erwinkooiman/SquareWaveVoltammetry/README.md

# SquareWaveVoltammetry
miniaturized potentiostat with web interface 
