erwinkooiman/SquareWaveVoltammetry/kiCad/PEE50_voltametrie.step

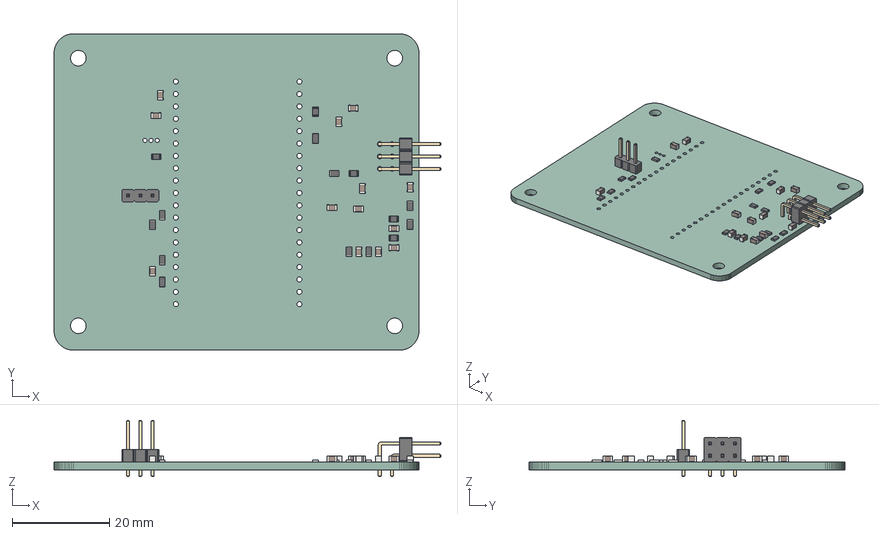
[picture p1: CAD file, 2023-06-14]
kiCad/PEE50_voltametrie.step
79.5 x 65.0 x 11.5 mm
PCB
