erwinkooiman/SquareWaveVoltammetry/kiCad/PEE50_voltametrie.kicad_pcb

## KiCad design kiCad/PEE50_voltametrie.kicad_pcb (2023-06-14)

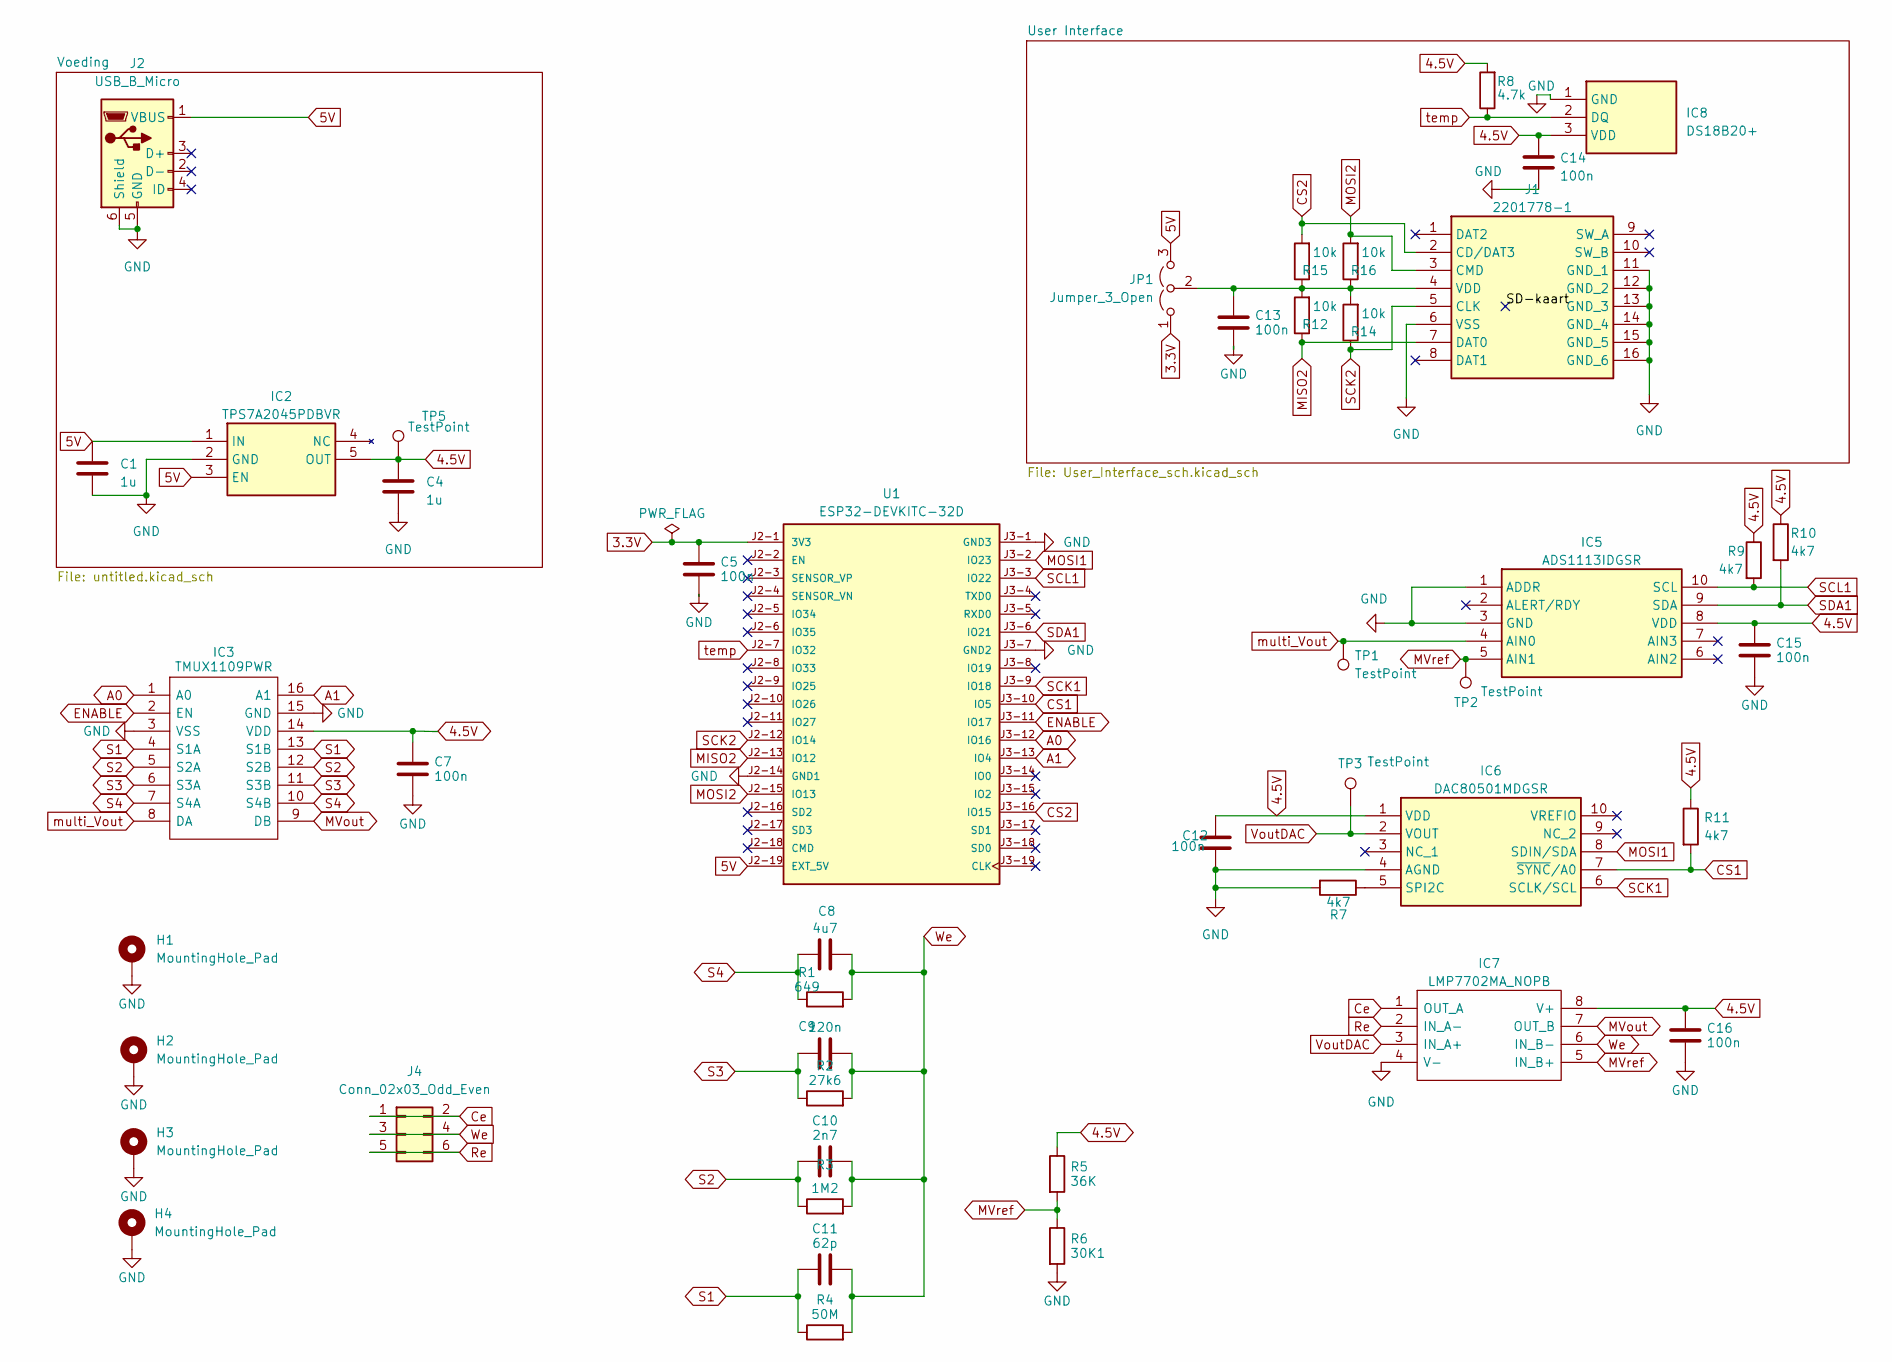
[picture p2: schematic PEE50_voltametrie.kicad_sch]

Parts:
C1, C4: 1u; C_0805_2012Metric_Pad1.18x1.45mm_HandSolder
C5, C7, C12, C13, C14, C15, C16: 100n; C_0805_2012Metric_Pad1.18x1.45mm_HandSolder
C8: 4u7; C_0805_2012Metric_Pad1.18x1.45mm_HandSolder
C9: 120n; C_0805_2012Metric_Pad1.18x1.45mm_HandSolder
C10: 2n7; C_0805_2012Metric_Pad1.18x1.45mm_HandSolder
C11: 62p; C_0805_2012Metric_Pad1.18x1.45mm_HandSolder
H1, H2, H3, H4: MountingHole_Pad; MountingHole_3.2mm_M3_DIN965_Pad
IC2: TPS7A2045PDBVR; SOT95P280X145-5N; Manufacturer_Part_Number TPS7A2045PDBVR; Mouser Part Number 595-TPS7A2045PDBVR
IC3: TMUX1109PWR; SOP65P640X120-16N; Manufacturer_Part_Number TMUX1109PWR; Mouser Part Number 595-TMUX1109PWR
IC5: ADS1113IDGSR; SOP50P490X110-10N; Manufacturer_Part_Number ADS1113IDGSR; Mouser Part Number 595-ADS1113IDGSR
IC6: DAC80501MDGSR; SOP50P490X110-10N; Manufacturer_Part_Number DAC80501MDGSR; Mouser Part Number 595-DAC80501MDGSR
IC7: LMP7702MA_NOPB; SOIC127P600X175-8N; Manufacturer_Part_Number LMP7702MA/NOPB; Mouser Part Number 926-LMP7702MA/NOPB
IC8: DS18B20+; DS18B20; Manufacturer_Part_Number DS18B20+; Mouser Part Number 700-DS18B20+
J1: 2201778-1; 22017781; Manufacturer_Part_Number 2201778-1; Mouser Part Number 571-2201778-1
J2: USB_B_Micro; USB_Micro-B_Amphenol_10104110_Horizontal
J4: Conn_02x03_Odd_Even; PinHeader_2x03_P2.54mm_Horizontal
JP1: Jumper_3_Open; PinHeader_1x03_P2.54mm_Vertical
R1: 649; R_0805_2012Metric_Pad1.20x1.40mm_HandSolder
R2: 27k6; R_0805_2012Metric_Pad1.20x1.40mm_HandSolder
R3: 1M2; R_0805_2012Metric_Pad1.20x1.40mm_HandSolder
R4: 50M; R_0805_2012Metric_Pad1.20x1.40mm_HandSolder
R5: 36K; R_0805_2012Metric_Pad1.20x1.40mm_HandSolder
R6: 30K1; R_0805_2012Metric_Pad1.20x1.40mm_HandSolder
R7, R9, R10, R11: 4k7; R_0805_2012Metric_Pad1.20x1.40mm_HandSolder
R8: 4.7k; R_0805_2012Metric_Pad1.20x1.40mm_HandSolder
R12, R14, R15, R16: 10k; R_0805_2012Metric_Pad1.20x1.40mm_HandSolder
TP1, TP2, TP3, TP5: TestPoint; TestPoint_Pad_D1.0mm
U1: ESP32-DEVKITC-32D; MODULE_ESP32-DEVKITC-32D; PARTREV V4

Connections:
3.3V: C5.1, JP1.1 (A), U1.J2-1 (3V3)
4.5V: C4.1, C7.1, C12.1, C14.1, C15.1, C16.1, IC2.5 (OUT), IC3.14 (VDD), IC5.8 (VDD), IC6.1 (VDD), IC7.8 (V+), IC8.3 (VDD), R5.1, R8.2, R9.1, R10.1, R11.1, TP5.1
5V: C1.1, IC2.1 (IN), IC2.3 (EN), J2.1 (VBUS), JP1.3 (B), U1.J2-19 (EXT_5V)
A0: IC3.1 (A0), U1.J3-12 (IO16)
A1: IC3.16 (A1), U1.J3-13 (IO4)
CS1: IC6.7 (~SYNC/A0), R11.2, U1.J3-10 (IO5)
CS2: J1.2 (CD/DAT3), R15.2, U1.J3-16 (IO15)
Ce: IC7.1 (OUT_A), J4.1, J4.2
ENABLE: IC3.2 (EN), U1.J3-11 (IO17)
GND: C1.2, C4.2, C5.2, C7.2, C12.2, C13.2, C14.2, C15.2, C16.2, H1.1, H2.1, H3.1, H4.1, IC2.2 (GND), IC3.3 (VSS), IC3.15 (GND), IC5.1 (ADDR), IC5.3 (GND), IC6.4 (AGND), IC7.4 (V-), IC8.1 (GND), J1.6 (VSS), J1.11 (GND_1), J1.12 (GND_2), J1.13 (GND_3), J1.14 (GND_4), J1.15 (GND_5), J1.16 (GND_6), J2.5 (GND), J2.6 (Shield), R6.2, R7.2, U1.J2-14 (GND1), U1.J3-1 (GND3), U1.J3-7 (GND2)
MISO2: J1.7 (DAT0), R12.1, U1.J2-13 (IO12)
MOSI1: IC6.8 (SDIN/SDA), U1.J3-2 (IO23)
MOSI2: J1.3 (CMD), R16.2, U1.J2-15 (IO13)
MVout: IC3.9 (DB), IC7.7 (OUT_B)
MVref: IC5.5 (AIN1), IC7.5 (IN_B+), R5.2, R6.1, TP2.1
unnamed: IC6.5 (SPI2C), R7.1
unnamed: C13.1, J1.4 (VDD), JP1.2 (C), R12.2, R14.2, R15.1, R16.1
Re: IC7.2 (IN_A-), J4.5, J4.6
S1: C11.1, IC3.4 (S1A), IC3.13 (S1B), R4.1
S2: C10.1, IC3.5 (S2A), IC3.12 (S2B), R3.1
S3: C9.1, IC3.6 (S3A), IC3.11 (S3B), R2.1
S4: C8.1, IC3.7 (S4A), IC3.10 (S4B), R1.1
SCK1: IC6.6 (SCLK/SCL), U1.J3-9 (IO18)
SCK2: J1.5 (CLK), R14.1, U1.J2-12 (IO14)
SCL1: IC5.10 (SCL), R9.2, U1.J3-3 (IO22)
SDA1: IC5.9 (SDA), R10.2, U1.J3-6 (IO21)
VoutDAC: IC6.2 (VOUT), IC7.3 (IN_A+), TP3.1
We: C8.2, C9.2, C10.2, C11.2, IC7.6 (IN_B-), J4.3, J4.4, R1.2, R2.2, R3.2, R4.2
multi_Vout: IC3.8 (DA), IC5.4 (AIN0), TP1.1
temp: IC8.2 (DQ), R8.1, U1.J2-7 (IO32)

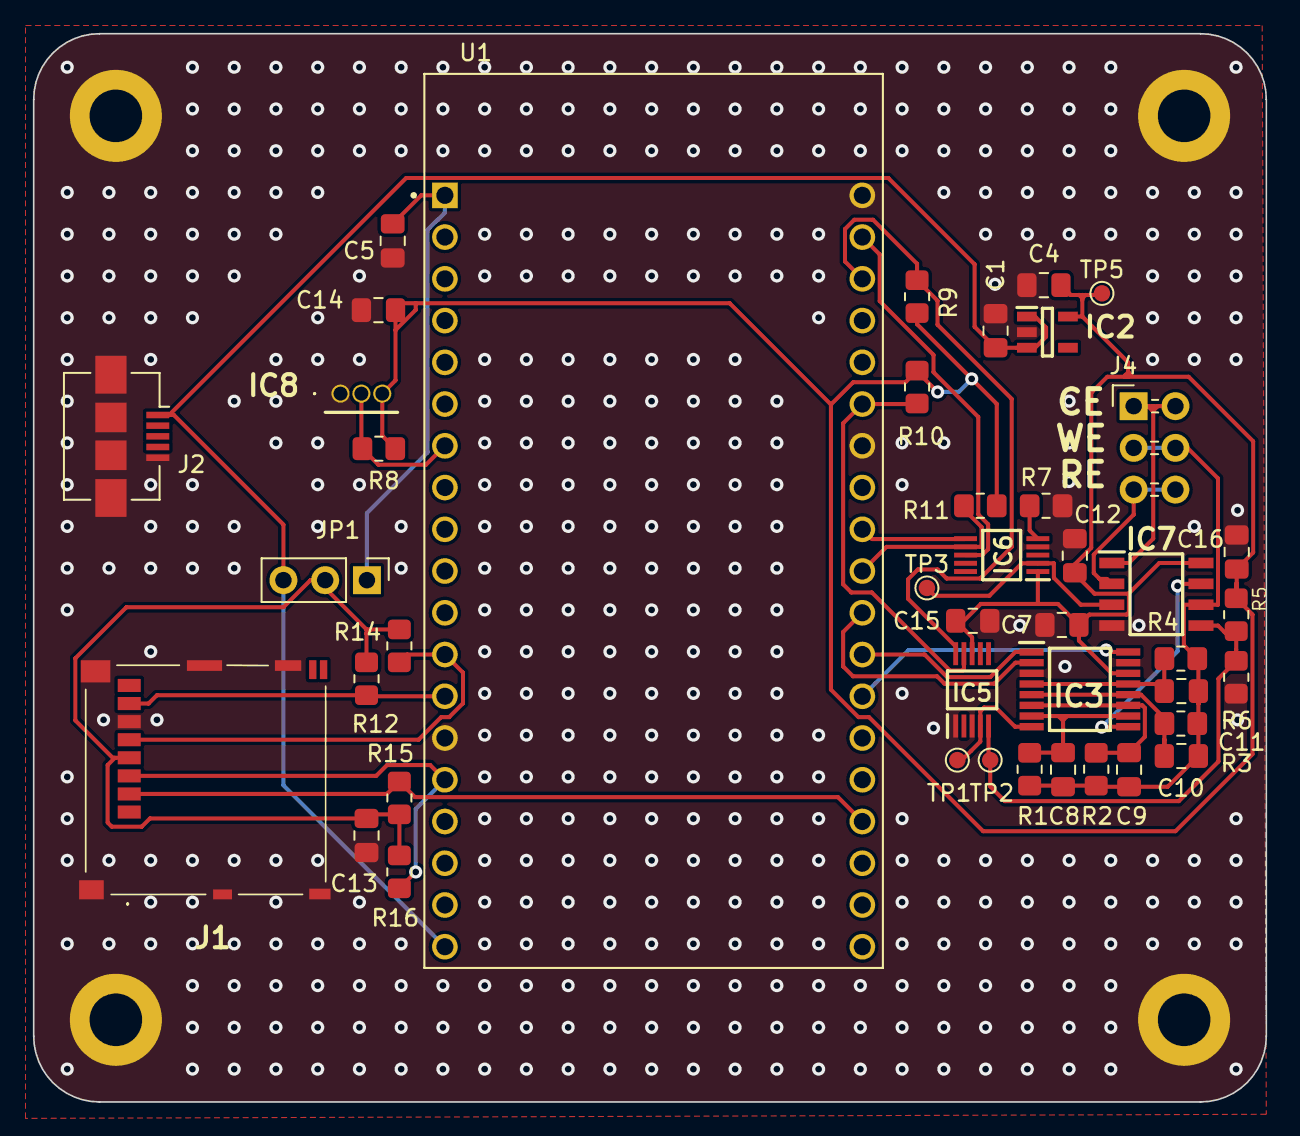
[picture p3: board PEE50_voltametrie.kicad_pcb from above]

Board: 2 copper layers, 75.0 x 65.0 mm, 48 parts (1 on the bottom side), 30 nets.

Other parts of the board:
G1: LOGO; hogeschool_rotterdam_logo
