erwinkooiman/SquareWaveVoltammetry/(commit log)

2023-06-05 removed unecessary printouts
2023-06-06 added kicad map
2023-06-06 Version 1 kicad files
    [PEE50_voltametrie.kicad_pcb, PEE50_voltametrie.kicad_sch, User_Interface_sch.kicad_sch, untitled.kicad_sch]
2023-06-06 Version 2 kicad files
    Before traces are added
    [PEE50_voltametrie.kicad_pcb, PEE50_voltametrie.kicad_sch]
2023-06-06 added temperature sensor
2023-06-06 Version 3 kicad
    Withoud 3.3V regulator not needed because of devkit
    [PEE50_voltametrie.kicad_pcb, PEE50_voltametrie.kicad_sch]
2023-06-06 layout aangepast
    [PEE50_voltametrie.kicad_pcb, PEE50_voltametrie.kicad_sch]
2023-06-12 check if SD card is detected, removed save button
2023-06-13 tested code
    [PEE50_voltametrie.kicad_pcb]
2023-06-13 Update SWV.ino
    small fix
    [SWV.ino]
2023-06-14 SPI pin changes
    [PEE50_voltametrie.kicad_pcb, PEE50_voltametrie.kicad_sch]
2023-06-14 final pcb update
    [PEE50_voltametrie-B_Cu.gbr, PEE50_voltametrie-B_Mask.gbr, PEE50_voltametrie-B_Paste.gbr, PEE50_voltametrie-B_Silkscreen.gbr, PEE50_voltametrie-Edge_Cuts.gbr, PEE50_voltametrie-F_Cu.gbr, PEE50_voltametrie-F_Mask.gbr, PEE50_voltametrie-F_Paste.gbr]
2023-06-22 fixed sd card upload bug
    [SWV.ino]
2023-06-27 potential now resets when finished
    [SWV.ino]
